refundmerch/Object-organizing-conveyor-system/Conveyor.SLDASM

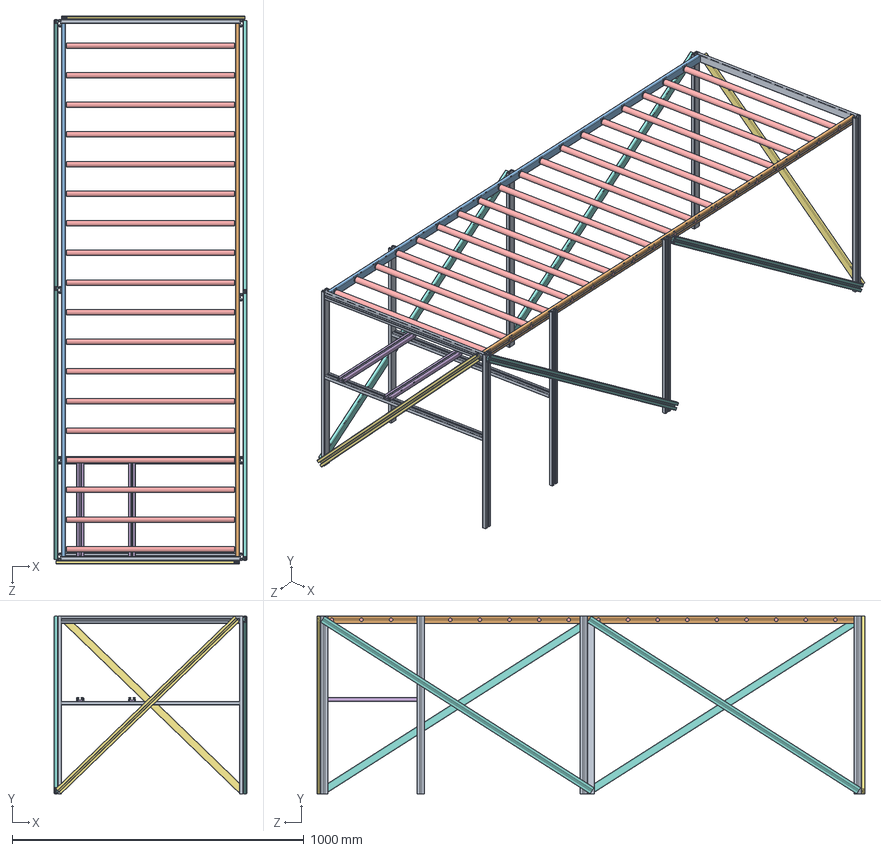
[picture p9: CAD file, 2022-05-17]
Conveyor.SLDASM
660.4 x 609.6 x 1879.6 mm
Short Extrusion x 12
Side Rail R
Side Rail L
Bearing x 36
Motor Mount x 2
Side Cross Bracing x 2
Length Cross Bracing x 4
