refundmerch/Object-organizing-conveyor-system/Short Extrusion.SLDPRT

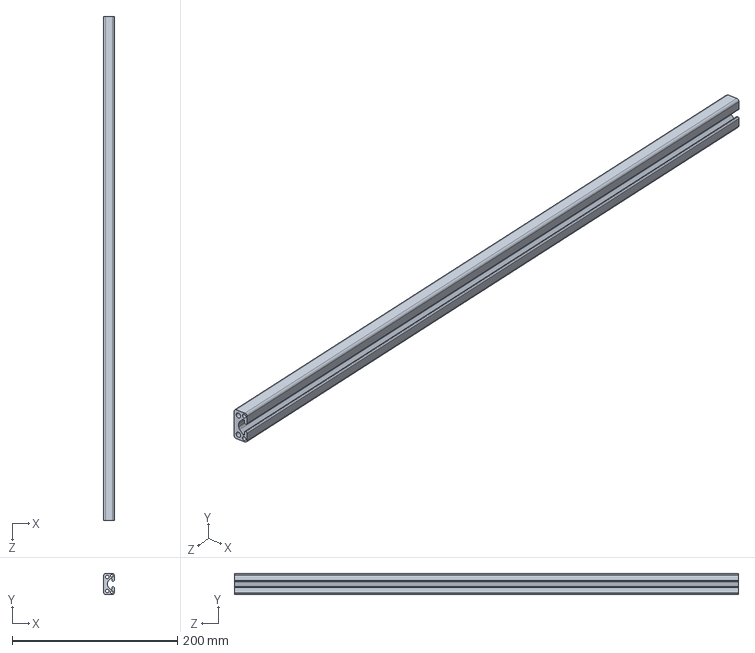
[picture p10: CAD file, 2022-05-17]
Short Extrusion.SLDPRT
12.7 x 25.4 x 609.6 mm
