refundmerch/Object-organizing-conveyor-system/Bearing.SLDPRT

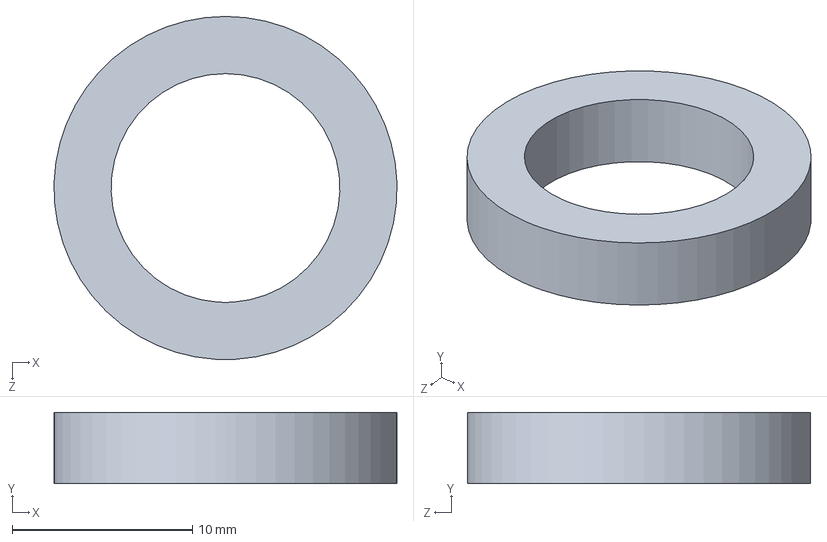
[picture p11: CAD file, 2022-05-17]
Bearing.SLDPRT
19.0 x 3.97 x 19.1 mm
