refundmerch/Object-organizing-conveyor-system/Side Cross Bracing.SLDPRT

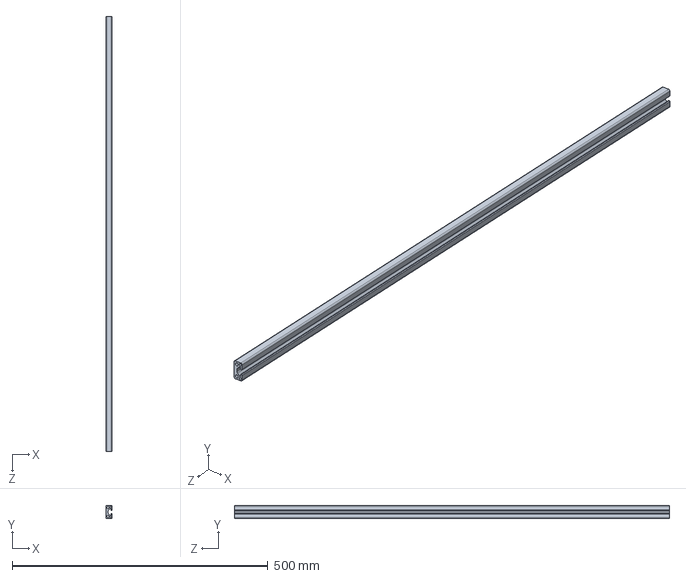
[picture p12: CAD file, 2022-05-17]
Side Cross Bracing.SLDPRT
12.7 x 25.4 x 850.9 mm
