refundmerch/Object-organizing-conveyor-system/Length Cross Bracing.SLDPRT

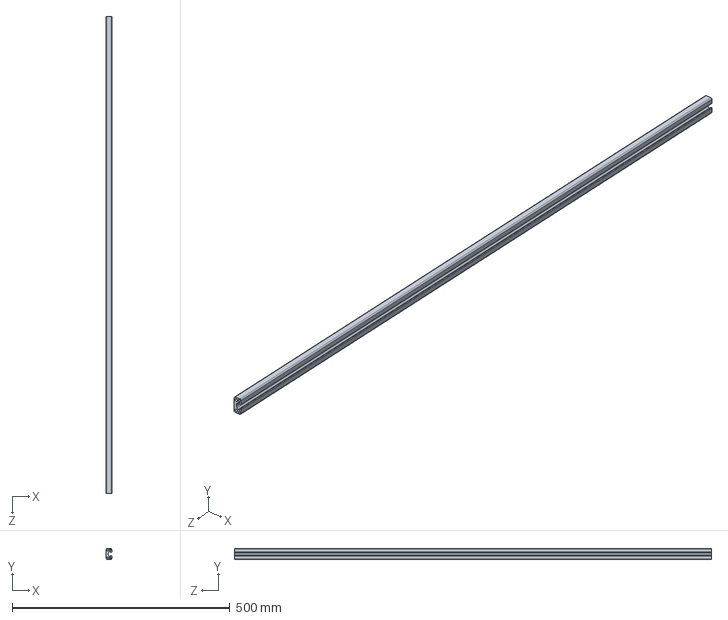
[picture p13: CAD file, 2022-05-17]
Length Cross Bracing.SLDPRT
12.7 x 25.4 x 1095.4 mm
