refundmerch/Object-organizing-conveyor-system/Motor Mount.SLDPRT

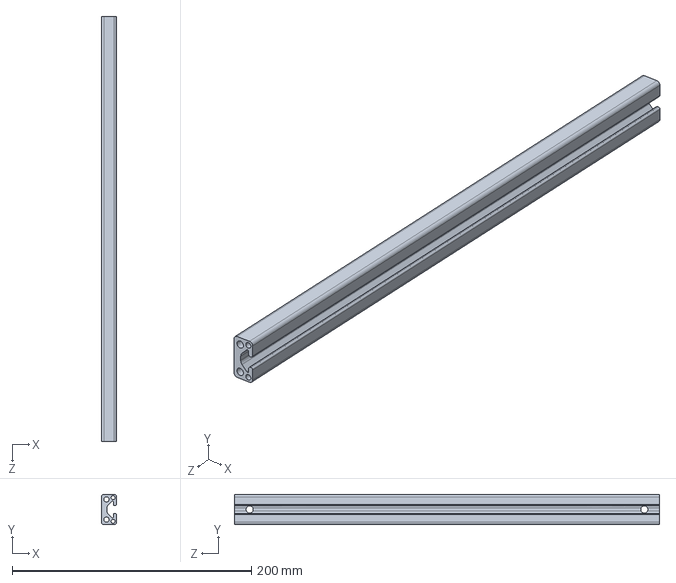
[picture p14: CAD file, 2022-05-17]
Motor Mount.SLDPRT
12.7 x 25.4 x 355.6 mm
