refundmerch/Object-organizing-conveyor-system/3136N341_T-Slotted Framing.SLDPRT

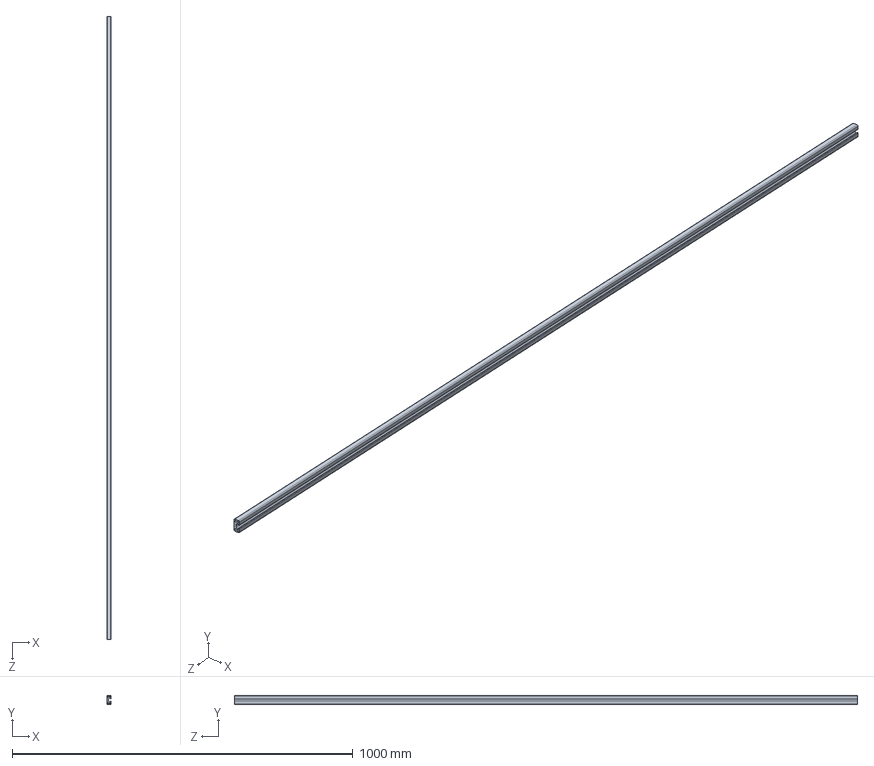
[picture p15: CAD file, 2022-05-17]
3136N341_T-Slotted Framing.SLDPRT
12.7 x 25.4 x 1828.8 mm
