refundmerch/Object-organizing-conveyor-system/5936K26_Rotary Shaft.SLDPRT

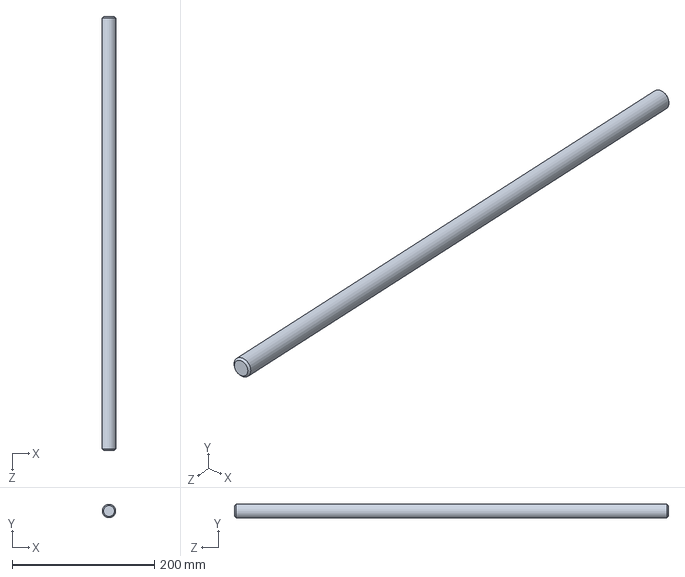
[picture p16: CAD file, 2022-05-17]
5936K26_Rotary Shaft.SLDPRT
19.1 x 19.1 x 609.6 mm
