refundmerch/Object-organizing-conveyor-system/5537T761_T-Slotted Framing.SLDPRT

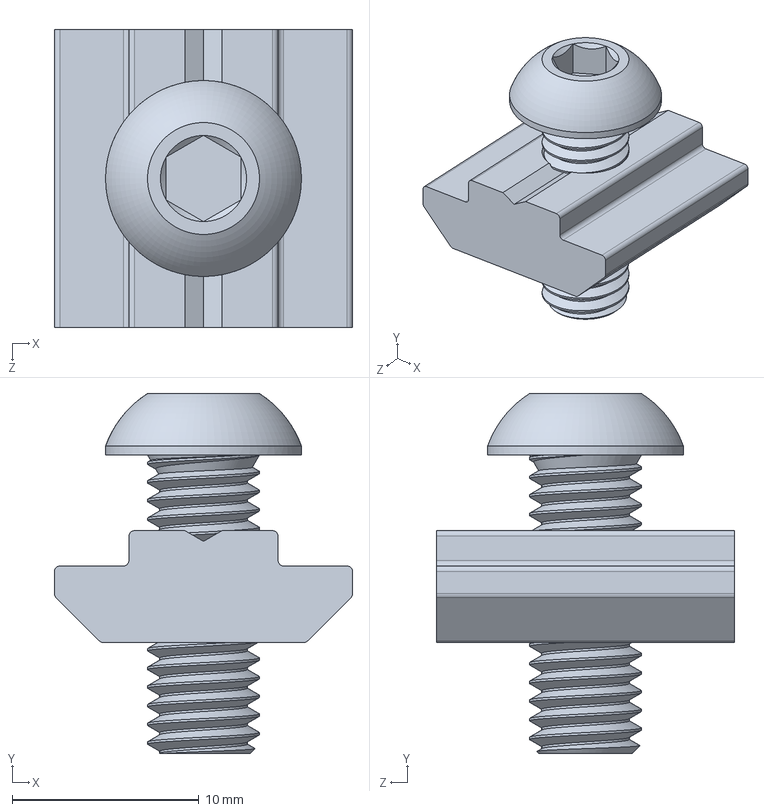
[picture p17: CAD file, 2022-05-17]
5537T761_T-Slotted Framing.SLDPRT
16.0 x 19.3 x 16.0 mm
