refundmerch/Object-organizing-conveyor-system/(list of files, cad)

Other CAD files:
Shaft.SLDPRT
